VaterAbraham78/ChickenGateSystem/NEXTION_Display/Hintergrund_2.jpg

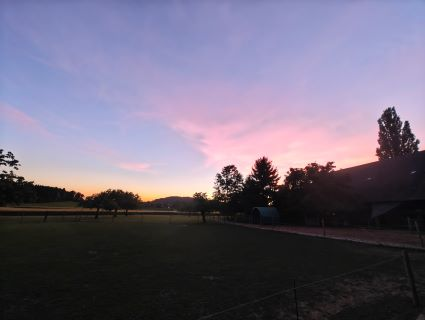
NEXTION_Display/Hintergrund_2.jpg
