VaterAbraham78/ChickenGateSystem/NEXTION_Display/Hintergrund.jpg

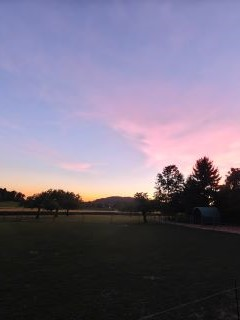
NEXTION_Display/Hintergrund.jpg
