VaterAbraham78/ChickenGateSystem/README.md

# ChickenGateSystem
Light-sensitive gate control system for an animal enclosure
