VaterAbraham78/ChickenGateSystem/Unterlagen/Nextion_Eingabefeld_Erkennbarkeit.docx

# Erkennbarkeit des Nextion-Zahlen-Eingabefelds

# Was aktuell erkennbar ist

Ereignis | Erkennbar? | Wie
Eingabe abgeschlossen, Wert bestätigt | Ja | 0x73-Telegramm im Postinitialize des Zahlenfelds
Eingabefeld geöffnet (Tastatur erscheint) | Nein | Kein Telegramm dafür vorgesehen
Eingabefeld geschlossen ohne Änderung (abgebrochen) | Nein | Es kommt gar kein Telegramm – für die Firmware unsichtbar

# Der Grund

Nur 0x65 (Touch-Ereignis), 0x66 (Seitenwechsel/sendme) und 0x73 (Direktübertragung nach Postinitialize) werden ausgewertet. 0x65 wird aktuell ausschliesslich für den Licht-Taster genutzt – Zahlenfelder senden laut Projektentwurf beim Antippen kein Touch-Ereignis, sondern erst beim Bestätigen ihren neuen Wert per 0x73.

# Warum das für den Sleepmode relevant ist

nexFrameAuswerten() frischt lastNextionActivity bei jedem erkannten Telegramm auf – unabhängig vom Typ. Öffnet jemand ein Zahlenfeld, überlegt lange und bricht dann ab (ohne einen neuen Wert zu bestätigen), bekommt die Firmware davon nichts mit. Die Inaktivitätszeit läuft in dieser Zeit unbeeindruckt weiter – im ungünstigsten Fall könnte die Nextion-Speisung mitten während einer offenen Eingabe abschalten.

# Was nötig wäre, um das zu schliessen

## Auf der Nextion-Seite

Im Nextion Editor bei jedem Zahlenfeld unter „Touch Press Event‘ die Option „Send Component ID‘ aktivieren – das würde beim Antippen (Öffnen der Tastatur) ein 0x65-Telegramm auslösen.

## Auf der Firmware-Seite

Die 0x65-Auswertung in nexFrameAuswerten() ist aktuell hart auf NEX_PAGE_BOXLIGHT/NEX_CID_LICHTTOGGLE beschränkt – für andere Felder würde das Telegramm zwar ankommen und bereits jetzt automatisch die Aktivitätszeit auffrischen (das passiert schon vor der Typ-Unterscheidung), aber es gäbe noch keinen eigenen „Eingabe ist gerade offen‘-Zustand, den man z. B. auch für sleepAllowed() nutzen könnte (ähnlich wie hmiReceiveInProgress das für laufenden Telegrammempfang schon tut).

# Offene Frage

Möchtest du, dass ich das ergänze – also einen expliziten „Eingabe läuft‘-Zustand einbaue, der sowohl die Inaktivitätszeit zuverlässig hält als auch den Sleepmode blockiert, solange eine Tastatur offen ist? Dafür müsstest du zusätzlich im Nextion-Projekt selbst die genannte Einstellung bei den betroffenen Feldern aktivieren.
