VaterAbraham78/ChickenGateSystem/Unterlagen/Stueckliste_RevE_20261012.xlsx

Stückliste Torsteuerung HUEST V3.0
Bauteil | Einbauort | Hersteller | Typennummer | Typen-Bezeichnung | Lieferant | Art.-Nr. | Einzelpreis | Total | Anzahl Soll
Haupt-Steuereinheit [HST-Main]:
Gehäuse Steuerschrank / 175*250*100 | --- | Swibox | SPCM182510T | Polycarbonat-Gehäuse / 175*250*100 / grauer Deckel / mit Einführungen | Swibox | SPCM182510T | CHF 50.00 | CHF 50.00 | 1
Scharniersatz | --- | Swibox | DSHI1 | Scharniersatz / zu "Cubo D/S" | Swibox | DSHI1 | CHF 10.00 | CHF 10.00 | 1
Wandbefestigungslaschen | --- | Swibox | SFL1 | Wandbefestigungslasche / zu "Cubo S" | Swibox | SFL1 | CHF 10.00 | CHF 0.00 | 0
Kabeleinführung - Kabelverschraubung M16 | --- | Jacob |  | Kabelverschraubung 3...10mm / M16*1,5 | Distrelec | 155-19-011 | CHF 0.80 | CHF 4.00 | 5
 |  |  |  |  |  |  |  | CHF 0.00
Stromversorgung 5VDC | --- | Traco-Power | TSR 1-2450 | DC/DC-Wandler, ITE, 1 Ausgang, 5 W, 5 V, 1 A, TSR 1 Series | Mouser | 495-TSR-1-2450 | CHF 4.70 | CHF 0.00 | 0
Stromversorgung 5VDC | --- | XP-Power | VR10S05 | DC/DC-Wandler, ITE, 1 Ausgang, 5 W, 5 V, 1 A | Mouser | 209-VR10S05 | CHF 8.60 | CHF 8.60 | 1
TVS-Überspannungsdiode 15,3V - Hauptspeisung & Motor | --- | LITTELFUSE | P6KE18A | TVS-Diode, P6KE, Unidirektional, 15.3 V, DO-204AC | Mouser | 576-P6KE18A | CHF 0.60 | CHF 1.80 | 3
Schottky-Diode für 5VDC-Linearregler | --- | Taiwan Semiconductor | 1N5822 | Schottky Diode, 3A, 40V | Mouser | 821-1N5822 | CHF 0.60 | CHF 0.60 | 1
Kondensator 220uF / 50V / 12DC Linearregler - Elko | --- | Panasonic | EEU-FR1H221 | Elektrolytkondensator, 220 µF, 50 V, ±20%, Radial, 8000 Stunden/105°C | Mouser | 667-EEU-FR1H221 | CHF 1.20 | CHF 1.20 | 1
Kondensator 10uF / 50V / 12DC Linearregler - Keramik | --- | TDK | FG20X7R1H106KRT00 | Keramik-Vielschichtkondensator MLCC – bedrahtet RAD 50V 10uF X7R 10% LS:5mm | Mouser | 810-FG20X7R1H106KRT0 | CHF 0.40 | CHF 0.40 | 1
Kondensator 22uF / 25V / 5VDC Linearregler - Keramik | --- | TDK | FG22X7R1E226MRT00 | Keramik-Vielschichtkondensator MLCC – bedrahtet RAD 25V 22uF X7R 20% LS:5mm | Mouser | 810-FG22X7R1E226MRT0 | CHF 0.40 | CHF 0.40 | 1
Kondensator 100nF / 25V / 5V-IC-Versorgung - Keramik | --- | KEMET | C320C104K3R5TA | Keramikkondensator, 0.1 µF, 25 V, ±10%, Radial, X7R, 2.54 mm | Mouser | 80-C320C104K3R5TA | CHF 0.40 | CHF 2.40 | 6
Kondensator 330nF / 25V / 5V-HMI-Versorgung - Keramik | --- | KEMET | C317C334K3R5TA | Keramikkondensator, 0.33 µF, 25 V, ±10%, Radial, X7R, 2.54 mm | Mouser | 80-C317C334K3R5TA | CHF 0.40 | CHF 0.40 | 1
Kondensator 1uF / 50V / Motorentstörung - Keramik | --- | TDK | FG24X7R1H105KRT00 | Keramik-Vielschichtkondensator MLCC – bedrahtet RAD 50V 1uF X7R 10% LS:5mm | Mouser | 810-FG24X7R1H105KRT0 | CHF 0.40 | CHF 0.40 | 1
Sicherungshalter für Radialsicherungen |  | Littelfuse | 55900000001 | Sicherungshalter, PCB, 1 Sicherung, 6.3A, 250V, TE5, TR5, THT | Mouser | 576-55900000001 | CHF 1.00 | CHF 2.00 | 2
Sicherungseinsatz / 2A / verzögert |  | Littelfuse | 37212000411 | Bedrahtete PCB-Sicherung, 2 A, 250 V, TR5 372, Zeitverzögerung | Farnell | 2786441 | CHF 1.00 | CHF 1.00 | 1
Sicherungseinsatz / 0,5A |  | Littelfuse | 37005000430 | Bedrahtete PCB-Sicherung, 500 mA, 250 V, TR5 370 Series, Flink | Farnell | 9515950 | CHF 1.00 | CHF 1.00 | 1
LED für Sicherung / rot / 3 mm / 3 mcd / r35° |  | BIVAR | 3HDL-F | LED, Rot, Durchsteckmontage, T-1 3/4 (3mm), 2 mA, 2 V, 625 nm | Mouser | 749-3HDL-F | CHF 0.40 | CHF 0.80 | 2
Touch-Display / 2,4" | --- | Nextion | NX3224T024 | Nextion 2.4 Zoll 320x240 TFT Touch Display ( Alternativ NX3224K028 ) | Mikroshop |  | CHF 29.00 | CHF 29.00 | 1
Atmega-Mikrocontroller | --- | Arduino | X000048 | ATmega328 mit Arduino Bootloader / ATMEGA328P-PN | Distrelec | 301-01-974 | CHF 7.00 | CHF 7.00 | 1
Werkzeug zu Mikrocontroller | --- | Aries | T-90 | T-90 Ausziehwerkzeug, IC-Entfernung | Mouser | 535-T-90 | CHF 8.35 | CHF 8.35 | 1
DIL-Sockel 28-polig | --- | TE-Connectivity | 1-2199298-9 | IC-Sockel, 28 Kontakte, 2.54 mm, 7.62 mm, Phosphorbronze | Mouser | 571-1-2199298-9 | CHF 0.70 | CHF 0.00 | 0
DIL-Sockel 28-polig | --- | TE-Connectivity | 2485264-7 | IC-Sockel, 28 Kontakte, 2.54 mm, 7.62 mm, Goldkontakt | Mouser | 571-2485264-7 | CHF 1.40 | CHF 1.40 | 1
Quarz 16MHz | --- | ECS International | ECS-160-18-4X-CKM | Quarz, 16 MHz, Durchsteckmontage, 10 ppm, 18 pF | Mouser | 520-ECS160-18-4X-CKM | CHF 0.35 | CHF 0.00 | 0
Quarz 16MHz | --- | IQD | LFXTAL027945 | Quarz, 16 MHz, Durchsteckmontage, 30 ppm, 20 pF | Mouser | 449-LFXTAL027945REEL | CHF 0.35 | CHF 0.35 | 1
Kondensator 30pF | --- | KEMET | C315C300F3G5TA | Keramikkondensator, 30 pF, 25 V, ±1%, Radial, GoldMax, 2.54 mm | Mouser | 80-C315C300F3G5TA | CHF 1.10 | CHF 3.30 | 3
Widerstand 100 Ohm | --- | Vishay | MBB02070C1000FCT00 | Widerstand, 600mW, 100 Ohm, 1 % | Mouser | 594-MBB02070C1000FCT | CHF 0.10 | CHF 0.40 | 4
Widerstand 220 Ohm | --- | Vishay | MBB02070C2200FCT00 | Widerstand, 600mW, 220 Ohm, 1 % | Mouser | 594-MBB02070C2200FCT | CHF 0.20 | CHF 0.40 | 2
Widerstand 470 Ohm | --- | Vishay | MBB02070C4700FCT00 | Widerstand, 600mW, 470 Ohm, 1 % | Mouser | 594-MBB02070C4700FCT | CHF 0.10 | CHF 0.20 | 2
Widerstand 1.1 kOhm | --- | Vishay | MBB02070C1101FCT00 | Widerstand, 600mW, 1,1 kOhm, 1 % | Mouser | 594-MBB02070C1101FCT | CHF 0.10 | CHF 0.10 | 1
Widerstand 2.2 kOhm | --- | Vishay | MBB02070C2201FCT00 | Widerstand, 600mW, 2,2 kOhm, 1 % | Mouser | 594-MBB02070C2201FCT | CHF 0.10 | CHF 0.60 | 6
Widerstand 4.7 kOhm | --- | Vishay | MBB02070C4701FCT00 | Widerstand, 600mW, 4,7 kOhm, 1 % | Mouser | 594-MBB02070C4701FCT | CHF 0.10 | CHF 0.10 | 1
Widerstand 10 kOhm | --- | Vishay | MBB02070C1002FCT00 | Widerstand, 600mW, 10 kOhm, 1 % | Mouser | 594-MBB02070C1002FCT | CHF 0.10 | CHF 1.10 | 11
Widerstand 47 kOhm | --- | Vishay | MBB02070C4702FCT00 | Widerstand, 600mW, 47 kOhm, 1 % | Mouser | 594-MBB02070C4702FCT | CHF 0.10 | CHF 0.10 | 1
Widerstand 100 kOhm | --- | Vishay | MBB02070C1003FCT00 | Widerstand, 600mW, 100 kOhm, 1 % | Mouser | 594-MBB02070C1003FCT | CHF 0.10 | CHF 0.20 | 2
Widerstand 200 kOhm | --- | Vishay | MBB02070C2003FCT00 | Widerstand, 600mW, 200 kOhm, 1 % | Mouser | 594-MBB02070C2003FCT | CHF 0.10 | CHF 0.20 | 2
Zenerdiode 4,7V - 2%-Toleranz | --- | VISHAY | BZX55B4V7-TAP | Zener-Diode, 4.7 V, 500 mW, DO-35, ± 2%-Tolerance | Mouser | 78-BZX55B4V7-TAP | CHF 0.50 | CHF 3.00 | 6
Zenerdiode 12.0V - 2%-Toleranz | --- | VISHAY | BZX55B12-TAP | Zener-Diode, 12 V, 500 mW, DO-35, ± 2%-Tolerance | Mouser | 78-BZX55B12-TAP | CHF 0.50 | CHF 0.50 | 1
Sperrdiode 100V - als Freilaufdiode | --- | Diotec Halbleiter | 1N4002 | Kleinsignaldiode, 100 V, 1A, DO-35 | Mouser | 637-1N4002 | CHF 0.10 | CHF 0.20 | 2
Sperrdiode 75V - für Sammelinterrupt | --- | Diotec Halbleiter | 1N4148 | Kleinsignaldiode, 75 V, 200mA, DO-35 | Mouser | 637-1N4148 | CHF 0.10 | CHF 0.40 | 4
Taster 1-polig | --- | Omron | B3F1005 | Kurzhubtaster , 1 Schliesser, 2.55N, 6 x 6mm | Mouser | 653-B3F-1005 | CHF 0.30 | CHF 0.30 | 1
LDR-Lichtabhängiger Widerstand | --- | Adafruit | 161 | 161 - CdS-Fotowiderstand, 5V | Distrelec | 301-39-054 | CHF 1.20 | CHF 0.00 | 0
LDR-Lichtabhängiger Widerstand (identisch) | --- | Advanced Photonix | PDV-P8001 | 161 - CdS-Fotowiderstand, 5V | Mouser | 846-PDV-P8001 | CHF 1.20 | CHF 1.20 | 1
MOSFET zur Relaissteuerung |  | Diodes Incorporated | ZVN4206A | Leistungs-MOSFET, n-Kanal, 60 V, 600 mA, 1 ohm, TO-92-3 | Mouser | 522-ZVN4206A | CHF 1.00 | CHF 2.00 | 2
MOSFET zur Leistungssteuerung |  | Infineon Technologies | IRLU024NPBF | Leistungs-MOSFET, n-Kanal, 55 V, 17 A, 0.065 ohm, TO-251-3 | Mouser | 942-IRLU024NPBF | CHF 1.50 | CHF 3.00 | 2
MOSFET / Leistungsschaltung |  | Taiwan Semiconductor | TSM680P06CH X0G | Leistungs-MOSFET, p-Kanal, 60 V, 18 A, 0.054 ohm, TO-251-S3 | Mouser | 821-TSM680P06CHX0G | CHF 1.50 | CHF 3.00 | 2
Bistabiles Relais / 2-polig / 12VDC |  | TE-Connectivity | RT424F12 | Relais / 2-Wechsler / Bistabil / 2-Spulen / 12VDC | Mouser | 655-RT424F12 | CHF 8.70 | CHF 8.70 | 1
Anschlussblock 2-polig / Gerätebuchse / Raster 5.08mm | --- | Phönix Contact | 1755736 | Steckbare Anschlussblöcke 2 Pos 5.08mm pitch Through Hole Header | Mouser | 651-1755736 | CHF 0.50 | CHF 1.00 | 2
Anschlussstecker 2-polig / Kabelstecker / Raster 5.08mm | --- | Phönix Contact | 1754568 | Steckbare Anschlussblöcke 2 Pos 5.08mm pitch Plug Spring | Mouser | 651-1754568 | CHF 2.10 | CHF 4.20 | 2
Anschlussblock 4-polig / Gerätebuchse / Raster 5.08mm | --- | Phönix Contact | 1755752 | Steckbare Anschlussblöcke 4 Pos 5.08mm pitch Through Hole Header | Mouser | 651-1755752 | CHF 1.40 | CHF 0.00 | 0
Anschlussstecker 4-polig / Kabelstecker / Raster 5.08mm | --- | Phönix Contact | 1754584 | Steckbare Anschlussblöcke 4 Pos 5.08mm pitch Plug Spring | Mouser | 651-1754584 | CHF 4.20 | CHF 0.00 | 0
Anschlussblock 2-polig / Gerätebuchse | --- | Phönix Contact | 1803426 | Steckbare Anschlussblöcke 2 Pos 3.81mm pitch Through Hole Header | Mouser | 651-1803426 | CHF 0.60 | CHF 0.00 | 0
Anschlussstecker 2-polig / Kabelstecker | --- | Phönix Contact | 1745894 | Steckbare Anschlussblöcke 2 Pos 3.81mm pitch Plug Spring | Mouser | 651-1745894 | CHF 1.70 | CHF 0.00 | 0
Anschlussblock 4-polig / Gerätebuchse | --- | Phönix Contact | 1803439 | Steckbare Anschlussblöcke 3 Pos 3.81mm pitch Through Hole Header | Mouser | 651-1803439 | CHF 0.90 | CHF 0.90 | 1
Anschlussstecker 4-polig / Kabelstecker | --- | Phönix Contact | 1745904 | Steckbare Anschlussblöcke 3 Pos 3.81mm pitch Plug Spring | Mouser | 651-1745904 | CHF 2.50 | CHF 2.50 | 1
Anschlussblock 4-polig / Gerätebuchse | --- | Phönix Contact | 1803442 | Steckbare Anschlussblöcke 4 Pos 3.81mm pitch Through Hole Header | Mouser | 651-1803442 | CHF 1.20 | CHF 3.60 | 3
Anschlussstecker 4-polig / Kabelstecker | --- | Phönix Contact | 1745917 | Steckbare Anschlussblöcke 4 Pos 3.81mm pitch Plug Spring | Mouser | 651-1745917 | CHF 3.40 | CHF 10.20 | 3
Anschlussblock 6-polig / Gerätebuchse | --- | Phönix Contact | 1803468 | Steckbare Anschlussblöcke 6 Pos 3.81mm pitch Through Hole Header | Mouser | 651-1803468 | CHF 1.80 | CHF 5.40 | 3
Anschlussstecker 6-polig / Kabelstecker | --- | Phönix Contact | 1748011 | Steckbare Anschlussblöcke 6 Pos 3.81mm pitch Plug Spring | Mouser | 651-1748011 | CHF 5.50 | CHF 16.50 | 3
 |  |  |  |  |  |  |  | CHF 204.40 | TOTAL
