VaterAbraham78/ChickenGateSystem/Unterlagen/Elektroschema_RevF.pdf

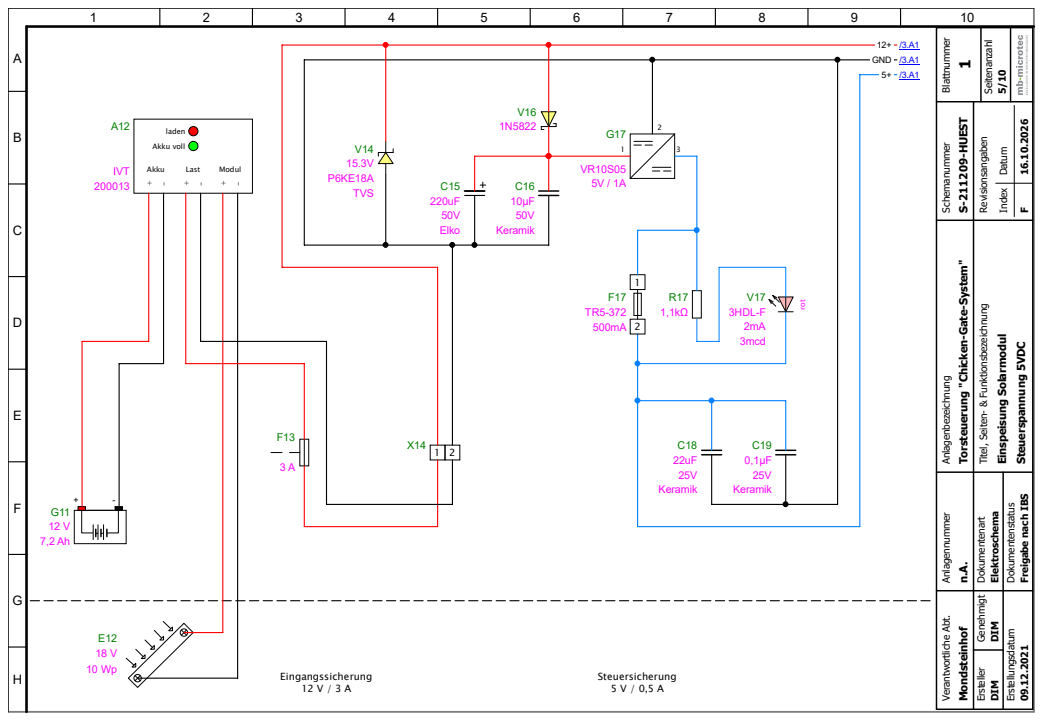
[picture p3: page 1]
Akku; Last; Modul; Akku voll; laden A12; IVT 200013; C18 22uF 25V Keramik; Eingangssicherung 12 V / 3 A; Steuersicherung 5 V / 0,5 A; C19 0,1µF 25V Keramik; C15 220uF 50V Elko; 12+ GND; V17 3HDL-F 2mA 3mcd; V14 15.3V P6KE18A TVS; rot; C16 10µF 50V Keramik; Verantwortliche Abt.; Mondsteinhof; Anlagenbezeichnung; Ersteller Genehmigt; DIM DIM; Anlagennummer; Dokumentenart; Elektroschema; Schemanummer; S-211209-HUEST; Dokumentenstatus; Erstellungsdatum 09.12.2021; Blattnummer 1; Revisionsangaben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

Torsteuerung "Chicken-Gate-System"

Titel, Seiten- & Funktionsbezeichnung

Freigabe nach IBS Steuerspannung 5VDC

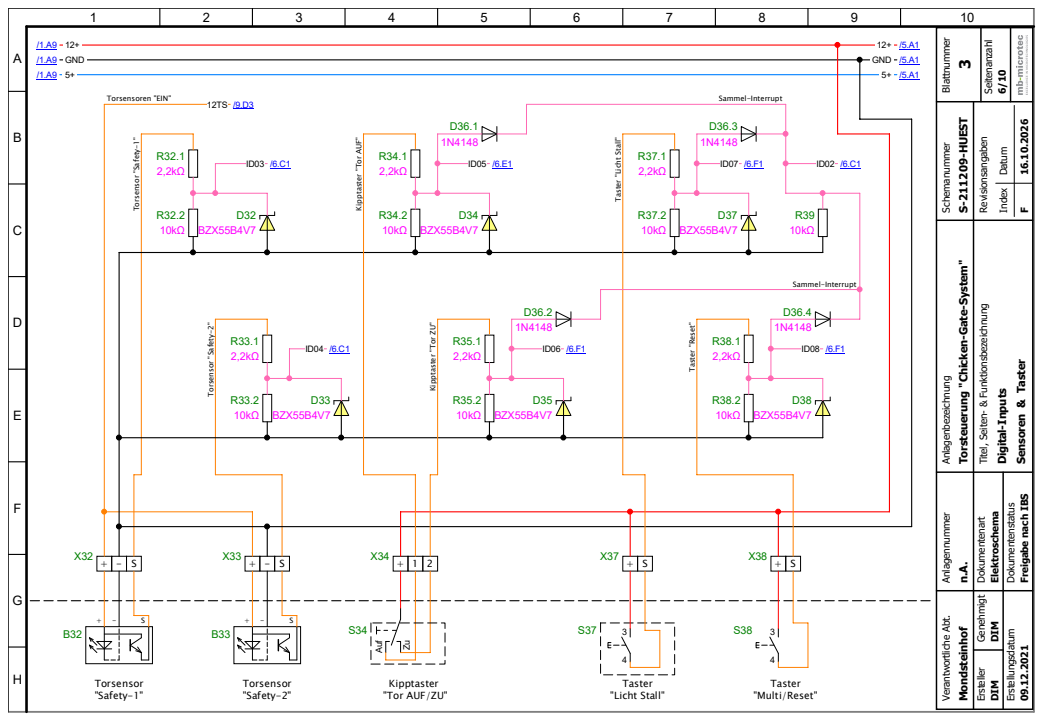
[picture p4: page 2]
GND; Torsensor "Safety-1"; Torsensor "Safety-2"; Auf; Taster "Licht Stall"; Taster "Multi/Reset"; D32 BZX55B4V7; D33 BZX55B4V7; D34 BZX55B4V7; D35 BZX55B4V7; D37 BZX55B4V7; D38 BZX55B4V7; Kipptaster "Tor AUF"; Kipptaster "Tor ZU"; Taster "Reset"; Sammel-Interrupt; Torsensoren "EIN"; Verantwortliche Abt.; Mondsteinhof; Anlagenbezeichnung; Ersteller Genehmigt; DIM DIM; Anlagennummer; Dokumentenart; Elektroschema; Schemanummer; S-211209-HUEST; Dokumentenstatus; Erstellungsdatum 09.12.2021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

Torsteuerung "Chicken-Gate-System"

Titel, Seiten- & Funktionsbezeichnung

Freigabe nach IBS Sensoren & Taster

Kipptaster
"Tor AUF/ZU"

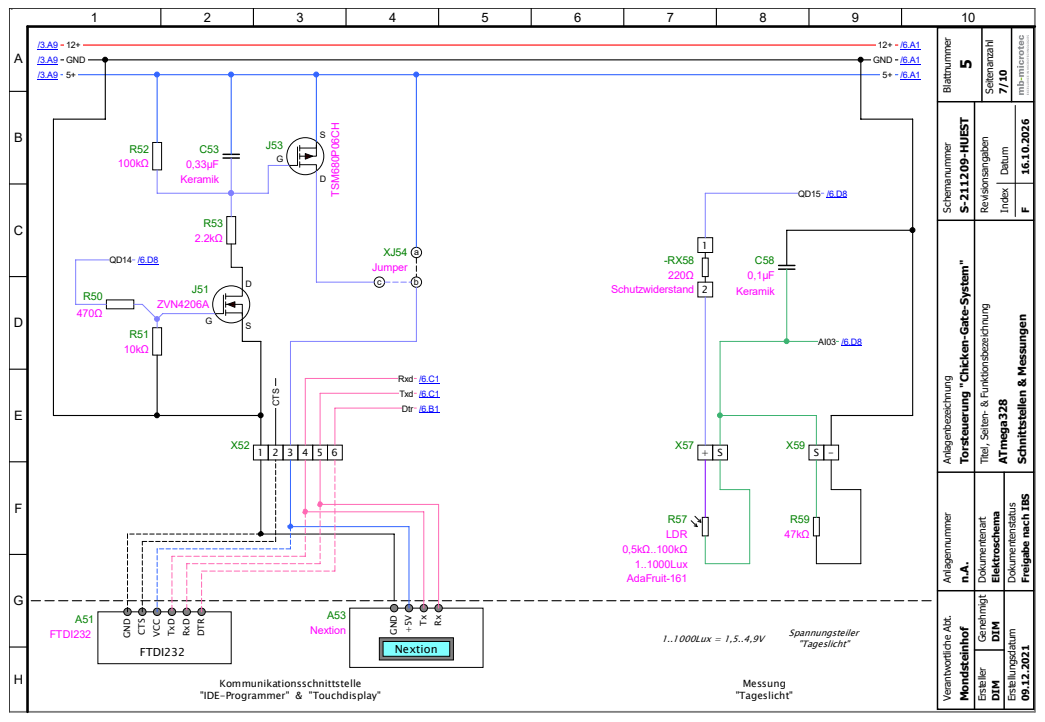
[picture p5: page 3]

Torsteuerung "Chicken-Gate-System"

Freigabe nach IBS Schnittstellen & Messungen

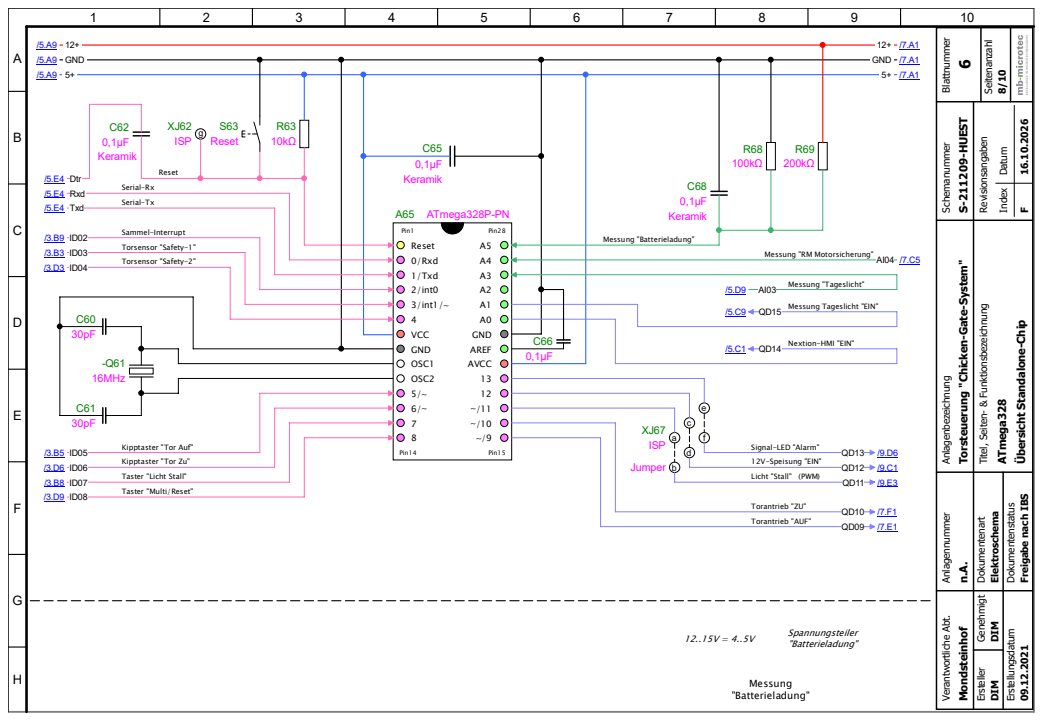
[picture p6: page 4]

Torsteuerung "Chicken-Gate-System"

Freigabe nach IBS Übersicht Standalone-Chip

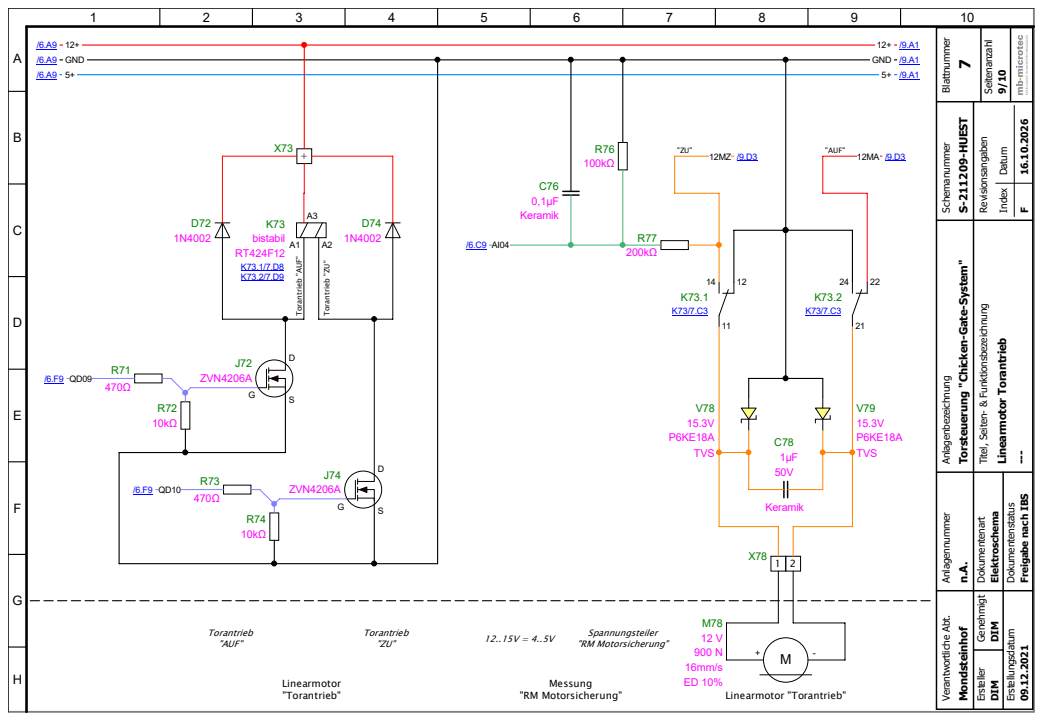
[picture p7: page 5]

Torsteuerung "Chicken-Gate-System"

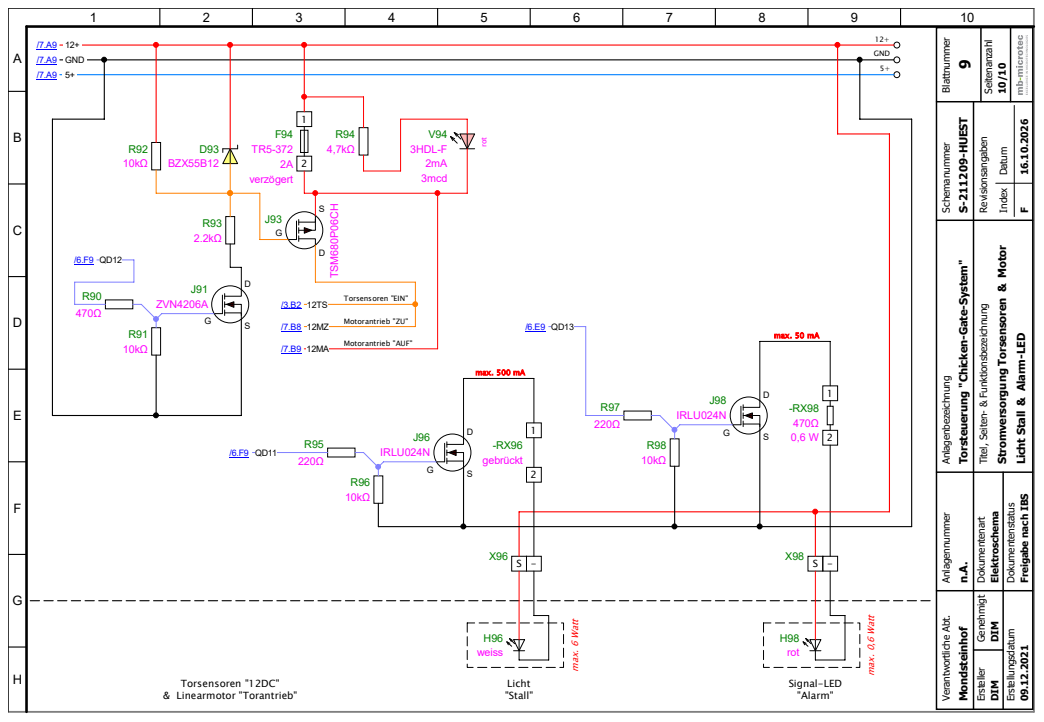
[picture p8: page 6]

Torsteuerung "Chicken-Gate-System"

Freigabe nach IBS Licht Stall & Alarm-LED
