VaterAbraham78/ChickenGateSystem/Unterlagen/Elektroschema_RevE.pdf

B

A

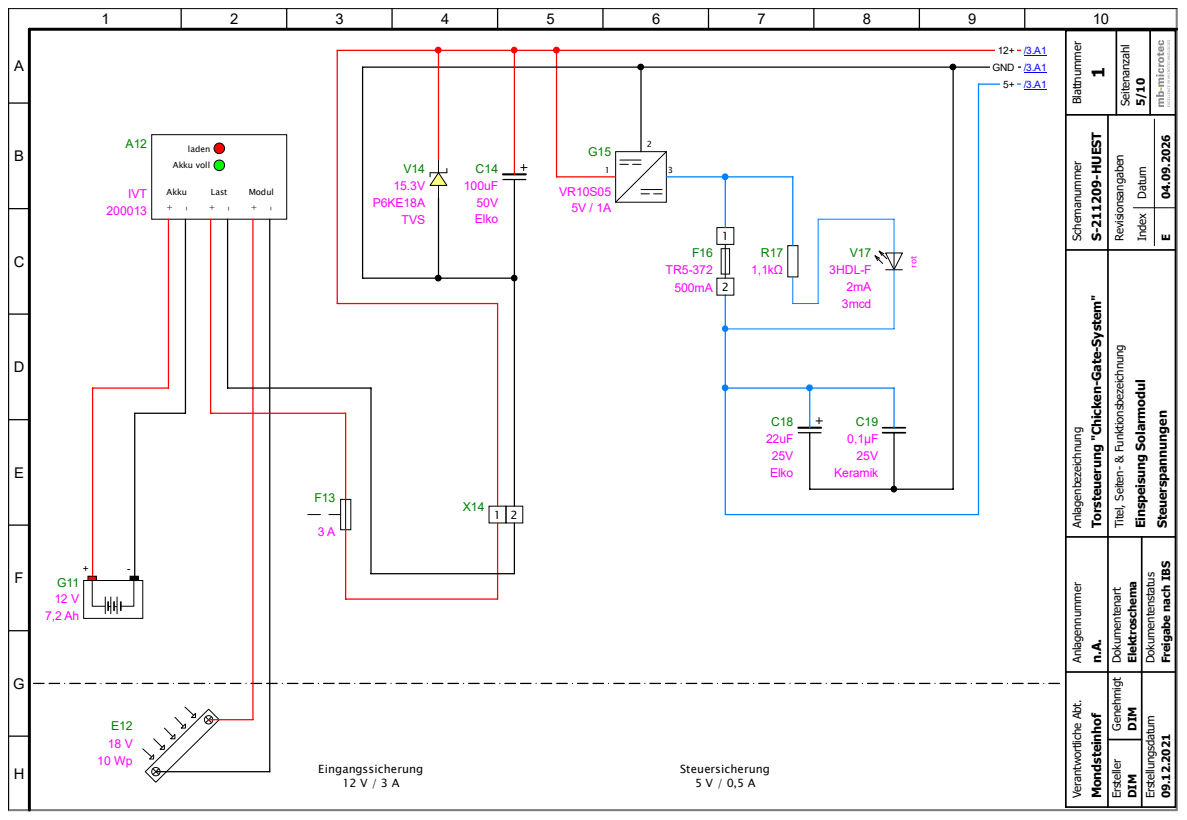
[picture p9: page 1]
Akku; Last; Modul; Akku voll; laden A12; IVT; Elko; Eingangssicherung 12 V / 3 A; Steuersicherung 5 V / 0,5 A; Keramik; GND; 3HDL-F; 3mcd; TVS; rot; Verantwortliche Abt.; Mondsteinhof; Anlagenbezeichnung; Ersteller Genehmigt; DIM DIM; Anlagennummer; Dokumentenart; Elektroschema; Schemanummer; S-211209-HUEST; Dokumentenstatus; Erstellungsdatum; Blattnummer 1; Revisionsangaben; Seitenanzahl; 5/10 Index Datum; Einspeisung Solarmodul

Torsteuerung "Chicken-Gate-System"

Titel, Seiten- & Funktionsbezeichnung

Freigabe nach IBS Steuerspannungen

B

A

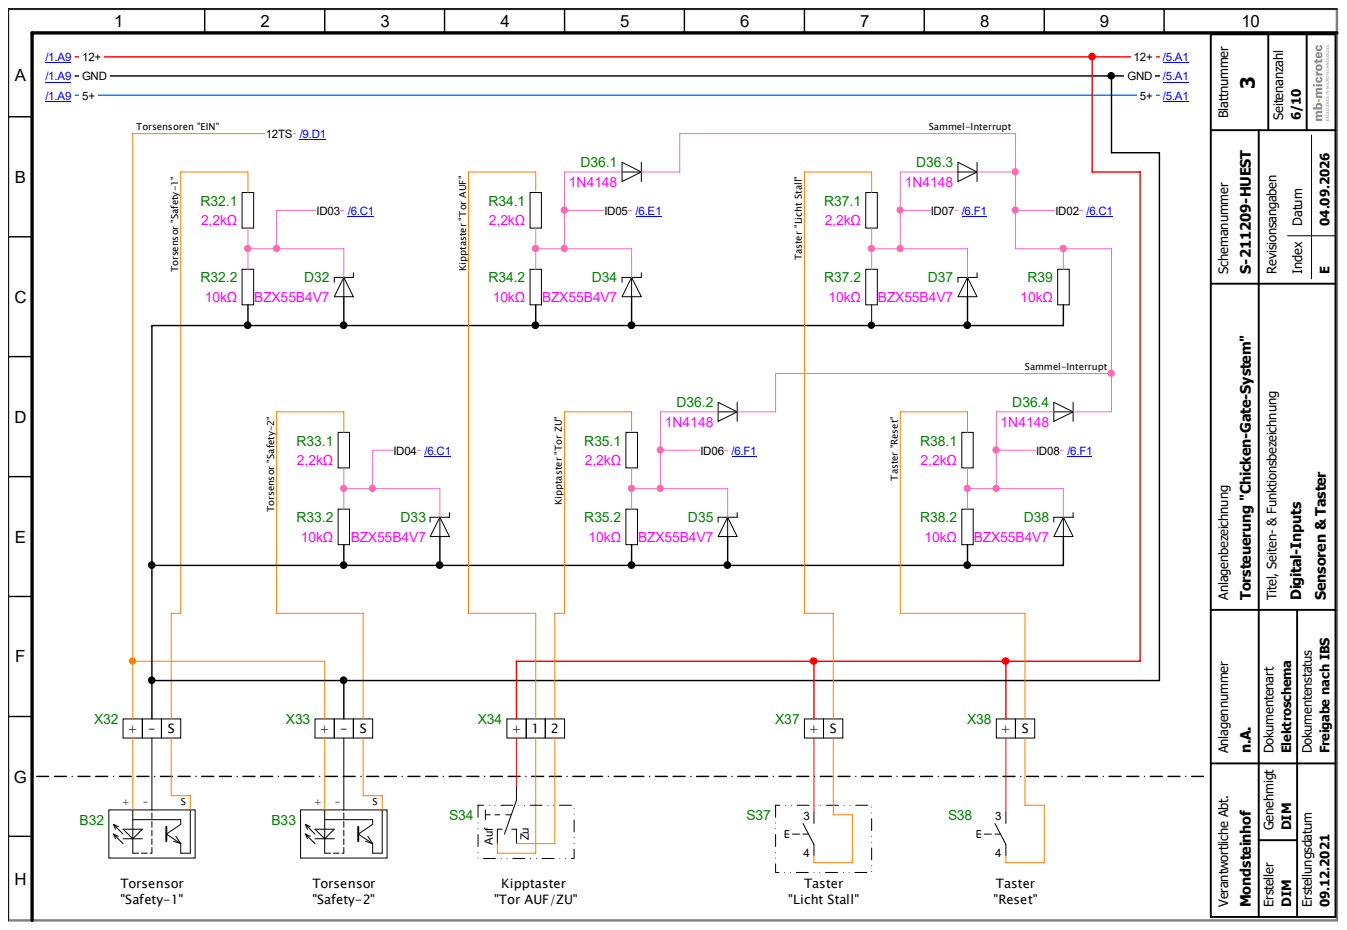
[picture p10: page 2]
GND; Torsensor "Safety-1"; Torsensor "Safety-2"; Auf; Taster "Licht Stall"; Taster "Reset"; BZX55B4V7; Kipptaster "Tor AUF"; Kipptaster "Tor ZU"; Sammel-Interrupt; Torsensoren "EIN"; Verantwortliche Abt.; Mondsteinhof; Anlagenbezeichnung; Ersteller Genehmigt; DIM DIM; Anlagennummer; Dokumentenart; Elektroschema; Schemanummer; S-211209-HUEST; Dokumentenstatus; Erstellungsdatum; Blattnummer 3; Revisionsangaben; Seitenanzahl; 6/10 Index Datum; Digital-Inputs

Torsteuerung "Chicken-Gate-System"

Titel, Seiten- & Funktionsbezeichnung

Freigabe nach IBS Sensoren & Taster

Kipptaster
"Tor AUF/ZU"

B

A

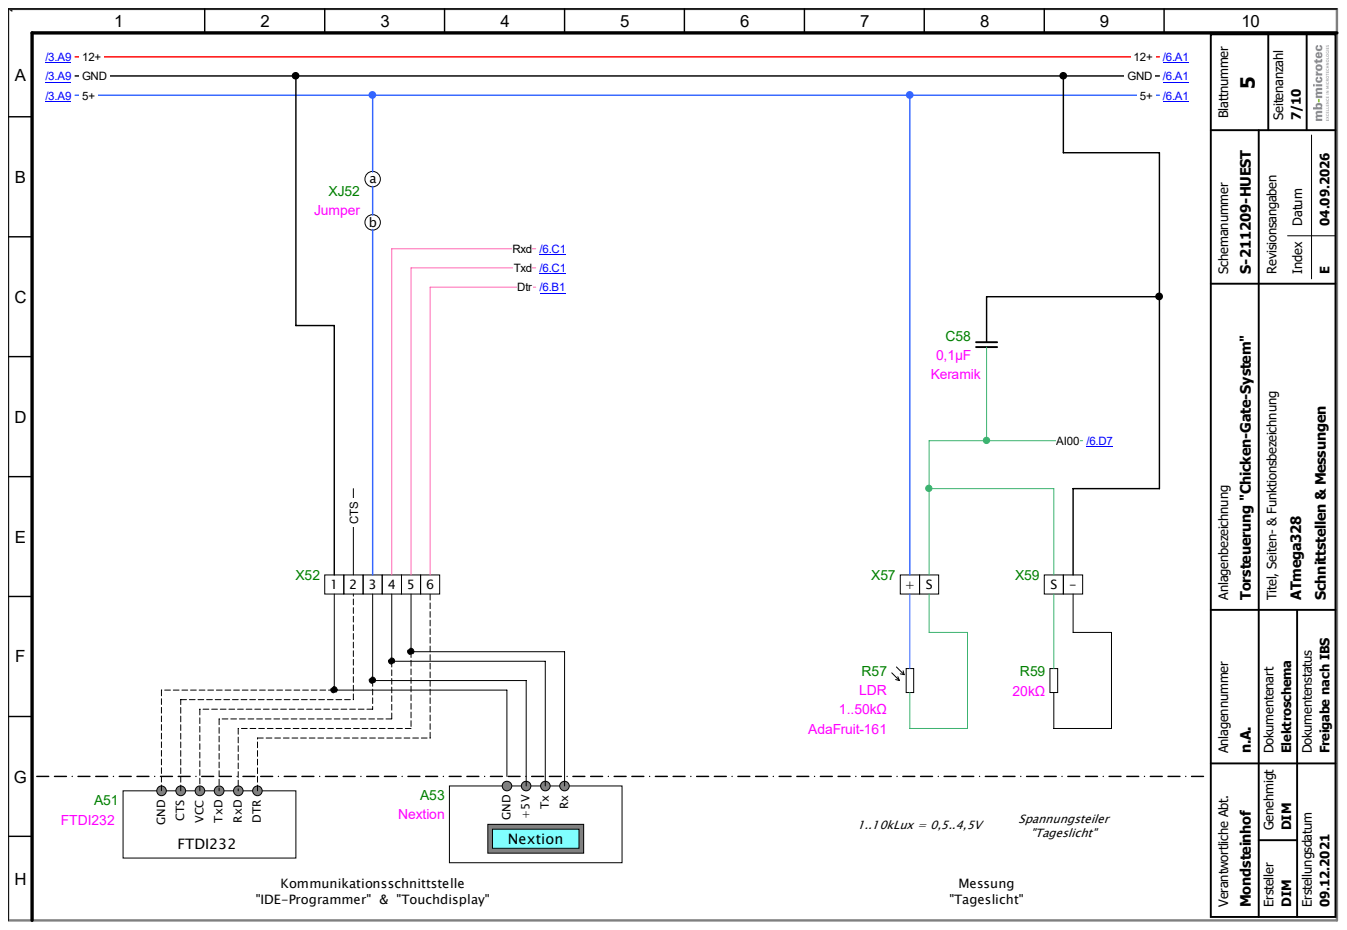
[picture p11: page 3]
GND; Messung "Tageslicht"; Spannungsteiler "Tageslicht"; LDR; AdaFruit-161; Keramik; CTS; Rxd; Txd; Dtr; VCC; TxD; RxD; DTR; FTDI232; Nextion; 1..10kLux = 0,5..4,5V; Jumper; Verantwortliche Abt.; Mondsteinhof; Anlagenbezeichnung; Ersteller Genehmigt; DIM DIM; Anlagennummer; Dokumentenart; Elektroschema; Schemanummer; S-211209-HUEST; Dokumentenstatus; Erstellungsdatum; Blattnummer 5; Revisionsangaben; Seitenanzahl; 7/10 Index Datum; ATmega328

Torsteuerung "Chicken-Gate-System"

Titel, Seiten- & Funktionsbezeichnung

Freigabe nach IBS Schnittstellen & Messungen

Kommunikationsschnittstelle
"IDE-Programmer" & "Touchdisplay"

B

A

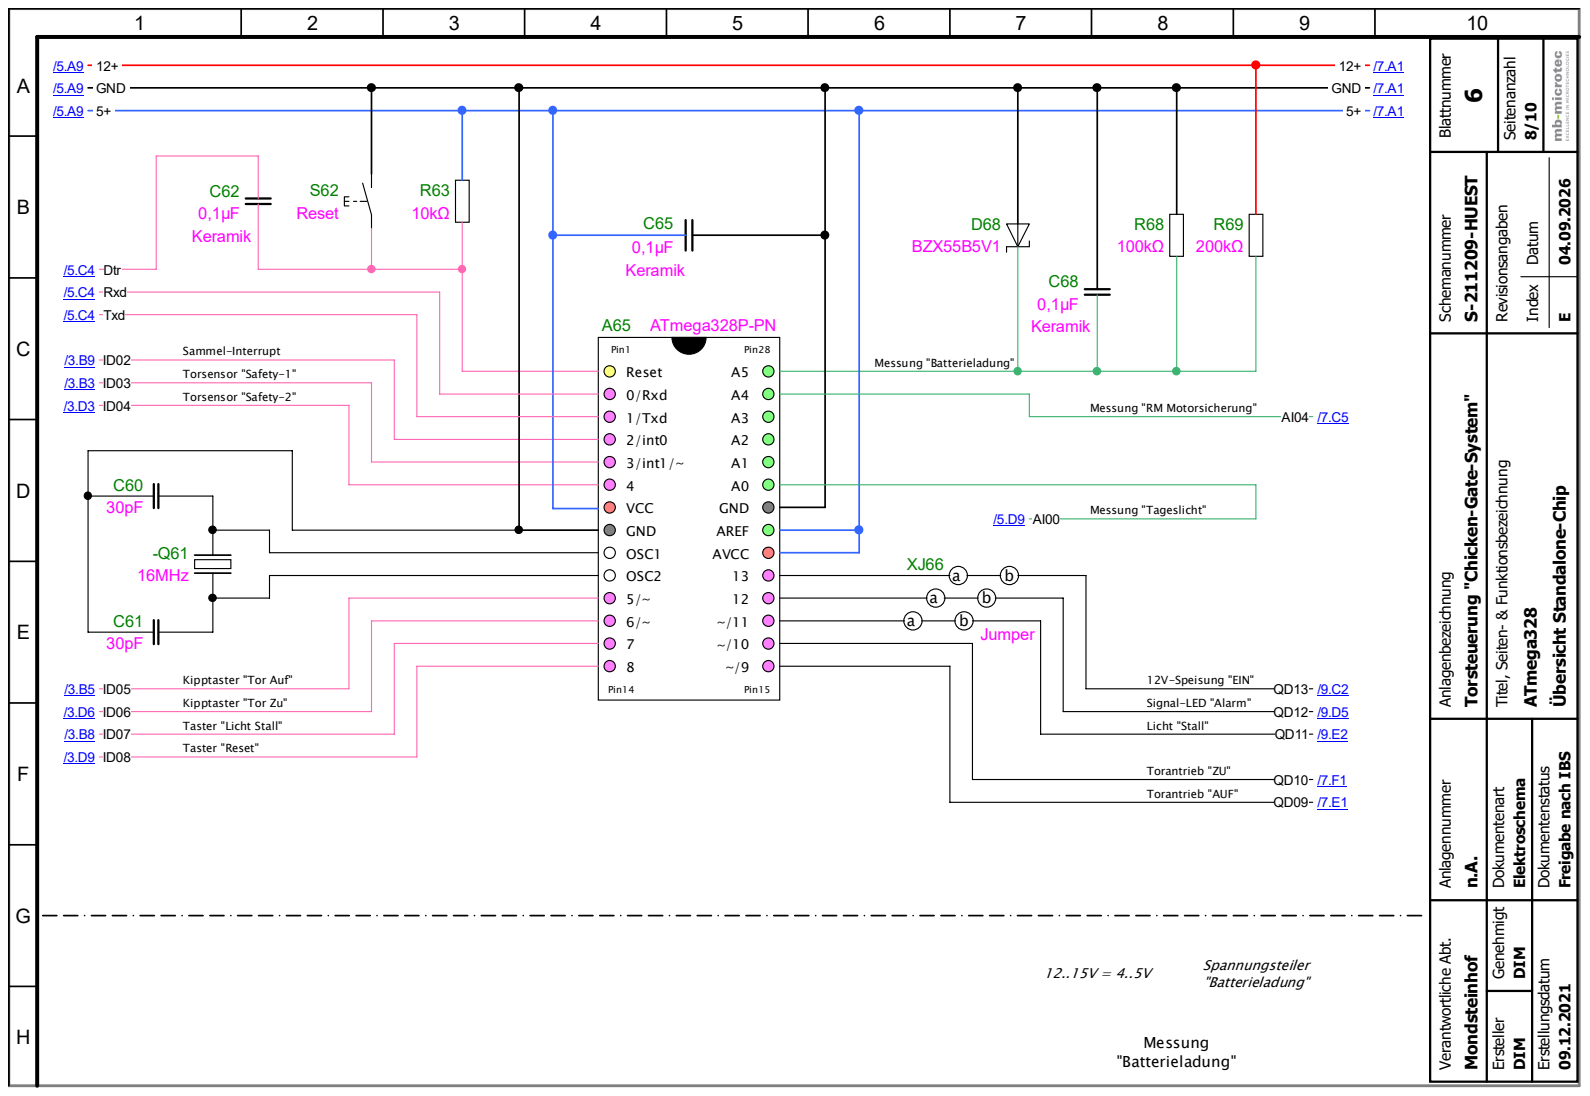
[picture p12: page 4]

Torsteuerung "Chicken-Gate-System"

Freigabe nach IBS Übersicht Standalone-Chip

B

A

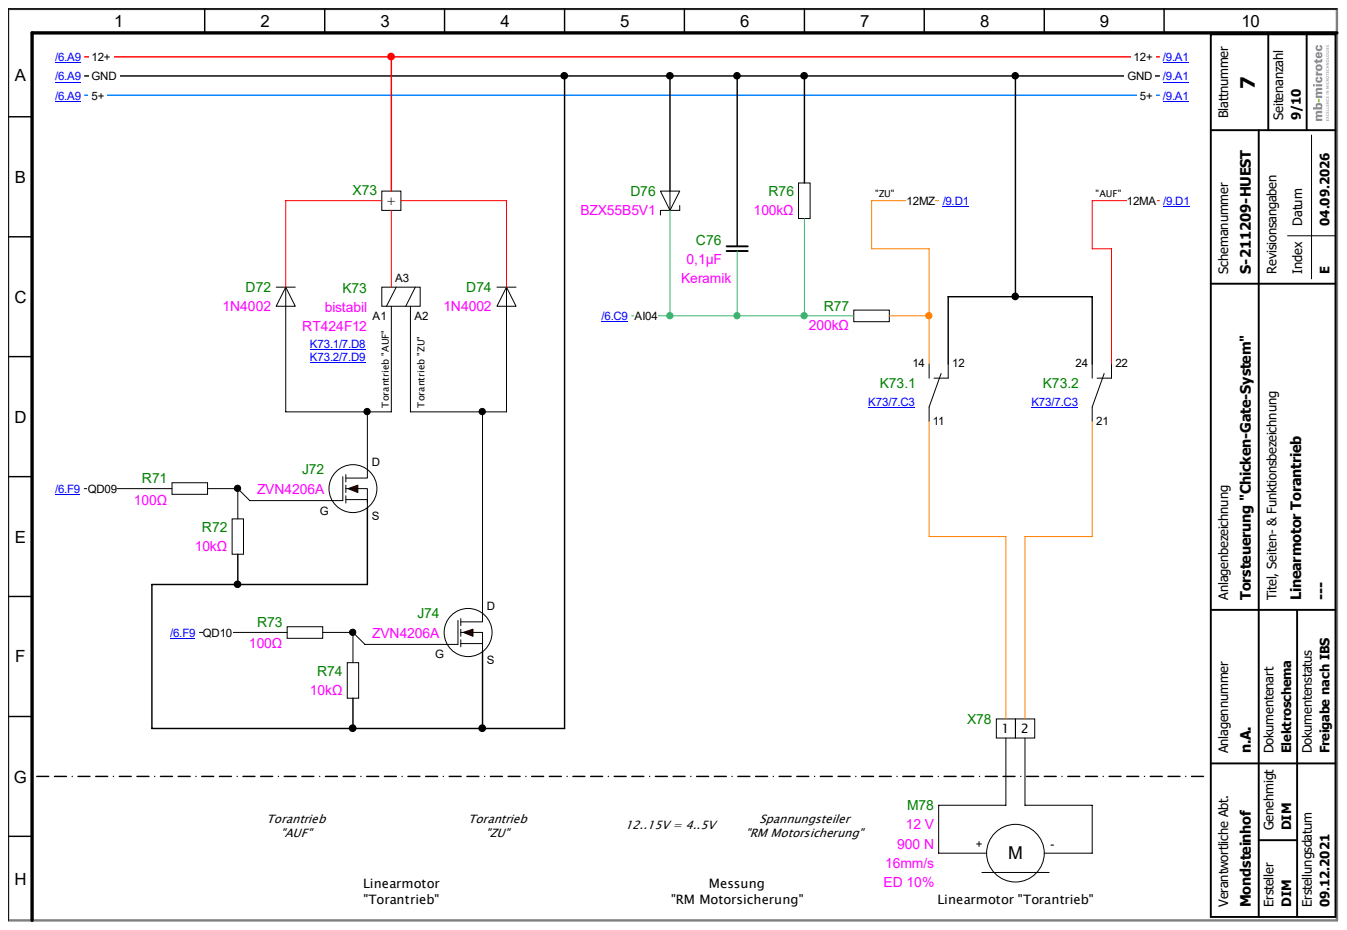
[picture p13: page 5]

Torsteuerung "Chicken-Gate-System"

B

A

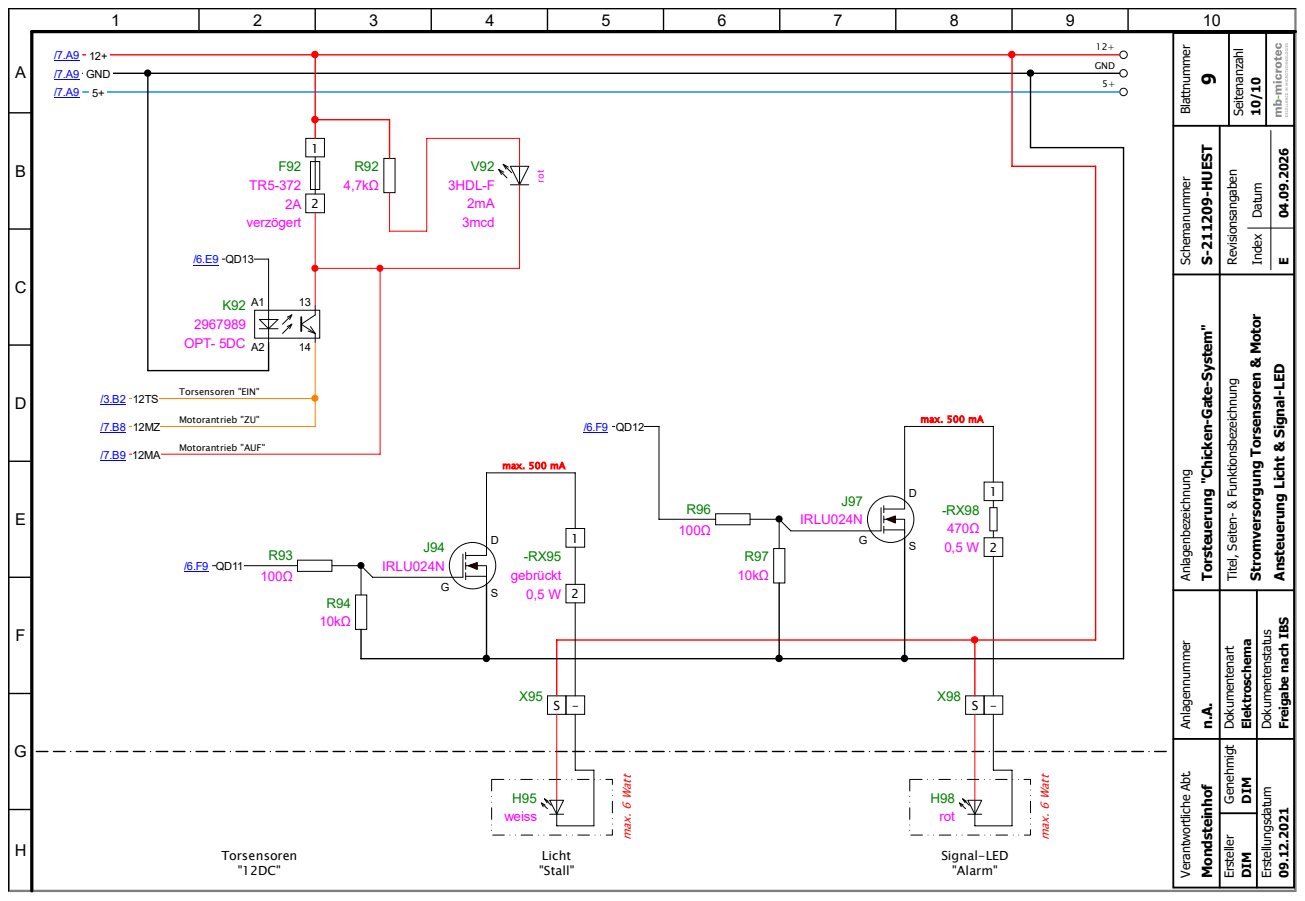
[picture p14: page 6]
GND; rot; weiss; gebrückt; max. 500 mA; max. 6 Watt; IRLU024N; OPT- 5DC; Torsensoren "EIN"; Licht "Stall"; Signal-LED "Alarm"; Torsensoren "12DC"; verzögert; Motorantrieb "ZU"; 3HDL-F; 3mcd; Motorantrieb "AUF"; Verantwortliche Abt.; Mondsteinhof; Anlagenbezeichnung; Ersteller Genehmigt; DIM DIM; Anlagennummer; Dokumentenart; Elektroschema; Schemanummer; S-211209-HUEST; Dokumentenstatus; Erstellungsdatum; Blattnummer 9; Revisionsangaben; Seitenanzahl; 10/10 Index Datum

Stromversorgung Torsensoren & Motor

Torsteuerung "Chicken-Gate-System"

Freigabe nach IBS Ansteuerung Licht & Signal-LED

Titel, Seiten- & Funktionsbezeichnung
