VaterAbraham78/ChickenGateSystem/(commit log)

2026-08-24 Nextion-HMI
    Neuerstellung des HMI-Files
2026-09-16 ChickenGateSytem_RevE_CorrV26
    Serielle Kommunikation aufgeteil ist case-Strukturen um loop-Zyklus nicht auszubremsen
2026-09-18 ChickenGateSytem_RevE_CorrV30.2
    Alarmstaten am HMI korrigiert
    HMI-Datenverlust mit mehreren Codeanpassungen versucht zu eliminieren...leider ohne erfolg
    [ChickenGateSytem_RevE.cpp, ChickenGateSytem_RevE.ino]
2026-09-20 ChickenGateSytem_RevE_CorrV31
    - Nextion-Kommunikation komplett umgebaut. Verwendet "sendme" als Anstosstreiber des Atmega um hmiSend() auszulösen
    - Nextion-Version 6 passend zu Rev.E31 (nicht abwärtskompatibel)
2026-09-20 ChickenGateSytem_RevE_CorrV31.2
    Kommentar und alte Funktionen entfernt
2026-09-29 ChickenGateSytem_RevE_CorrV36.2
    - HW-Pin geändert
    - Flankenerkennung Nextion-Speisung EIN
2026-09-30 ChickenGateSytem_RevE_CorrV37
    Sleepmode voll aktiv (1WDT-Zyklus)
    [Stueckliste_RevE_20260929.xlsx]
2026-10-09 ChickenGateSytem_RevE_CorrV40
    - Integration WDT auf 8Zyklen
    - Lichtmessung mit zwei Messperioden und diversen Funktionsaufrufen (WDT, Interrupt, FirstCycle, Periodisch)
    - GETESETET - ROLLOUT
